dorbalazs/big_muff_pi_2_bass/resources.pdf

Resources
- The Big Muff PI 2 schematic derived from the original paper-drawings (https://www.gigaheartsfx.com/products/gig-buff-pcb-v1_3)
- Electro Smash Big Muff PI analysis (https://www.electrosmash.com/big-muff-pi-analysis)
- Tonestack calculator (https://tonestack.yuriturov.com)
- Op-amp based fuzz (https://docs.pedalpcb.com/project/SourGrape.pdf)
- Why your clean blends suck (https://forum.pedalpcb.com/threads/why-your-clean-blends-suck-or-how-to-clean-blend.20986/)
- PedalPCB Red Muffin Fuzz (https://docs.pedalpcb.com/project/RedMuffin-PedalPCB.pdf)
- Obsidius Preamp - Darkglass B3K clone (https://docs.pedalpcb.com/project/Obsidius.pdf)
- Panner blend (http://www.geofex.com/Article_Folders/panner.pdf)
- Bass big muff trace (https://www.freestompboxes.org/viewtopic.php?f=1&p=285716&t=31296&sid=4f5c3a3a720bbd048505c8e43db66121)
- Changing the mid scoop frequency spectrum (https://www.coda-effects.com/2015/09/black-keyss-big-muff-dealing-with-mids.html)
- Way Huge Pickle clone (https://docs.pedalpcb.com/project/Gerkin.pdf)

v1
- use EQD Hoof tonestack
- omit “bass boost” from bass big muff - or rather not because it would be wasteful for a tl074
- gain of final makeup stage shall be ~2 (6dB)
- make the 68k series resistor in the bass blend path a 100k trimmer
- add passive master volume control
- make most blends trimmable/socketable

technical notes
- POM1615 pot datasheet (https://www.hestore.hu/prod_getfile.php?id=3109)
- Hestore 3PDT stompswitch (https://www.hestore.hu/prod_10038654.html)
- DPDT Switch (https://www.hestore.hu/prod_getfile.php?id=15750)
- 1590BB on Hammond’s site. (https://www.hammfg.com/part/1590BB)
- Audio Jack (https://www.hestore.hu/prod_getfile.php?id=19268)
- DC Jack (https://www.hestore.hu/prod_10038660.html)

TODO:
- create 3PDT footswitch daughter board. put the LED on there
- create 3d model for 3PDT footswitch using FreeCAD
- rethink the thing for a 1590BB
