dorbalazs/big_muff_pi_2_bass/bassmuff.png

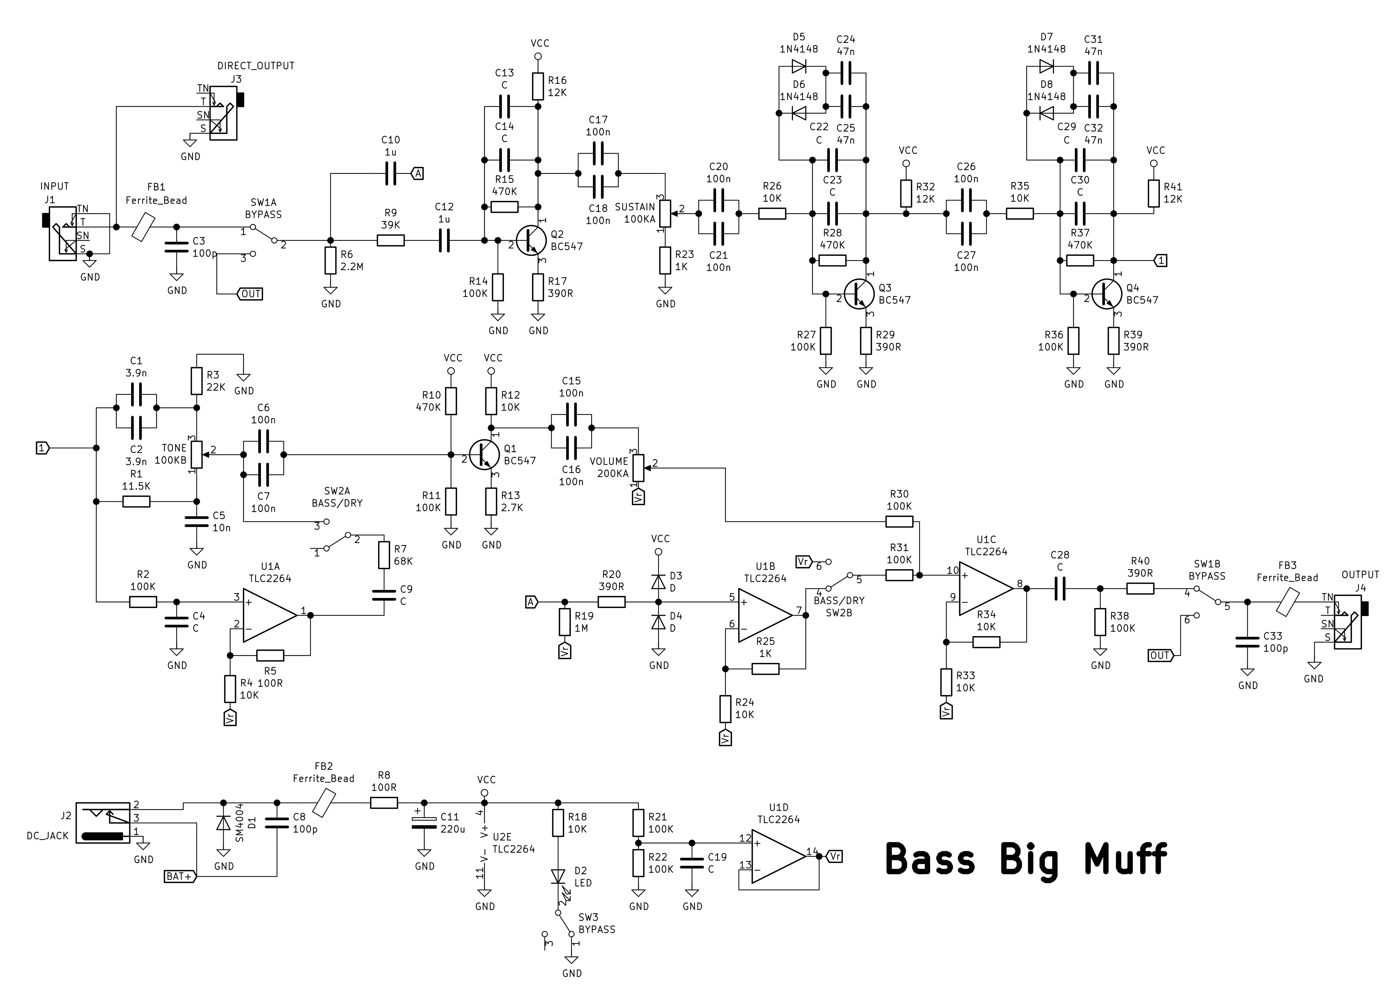
bassmuff.png
