dorbalazs/big_muff_pi_2_bass/exports/bass_big_muff2.pdf

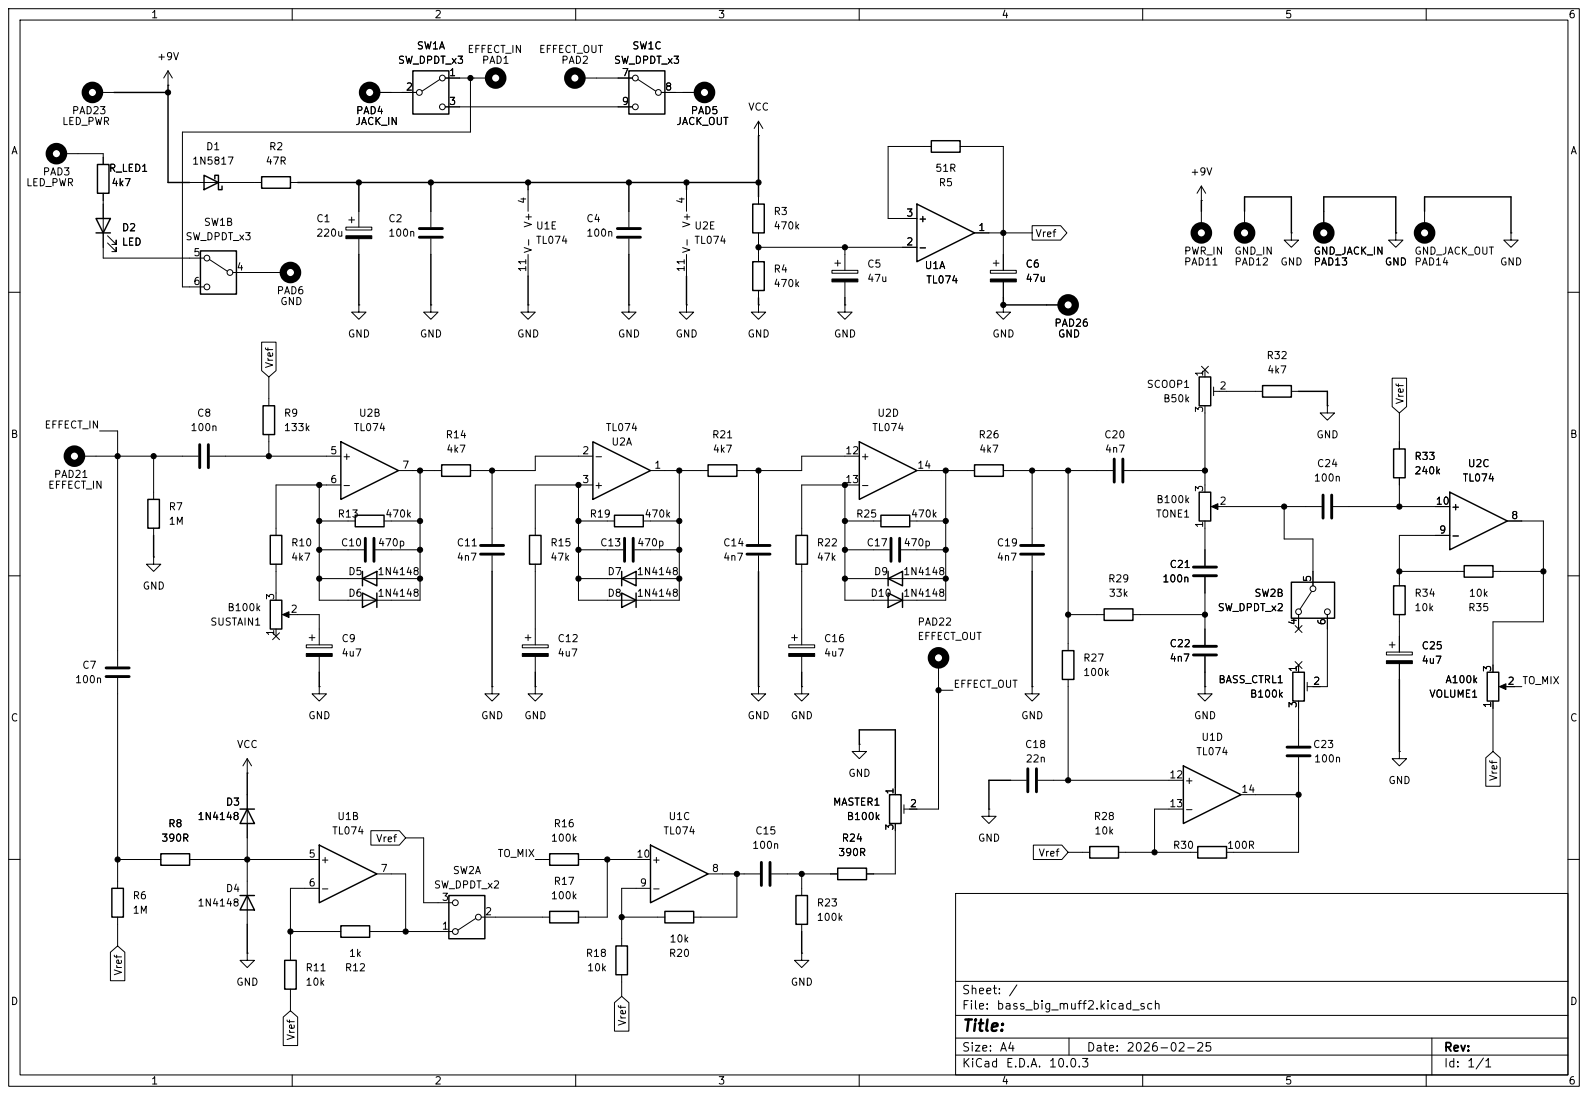
[picture p2: page 1]

Size: A4 | Rev:
KiCad E.D.A. 10.0.3 | Id: 1/1
