dorbalazs/big_muff_pi_2_bass/bass_big_muff2.kicad_pcb

## KiCad design bass_big_muff2.kicad_pcb (2026-07-04)

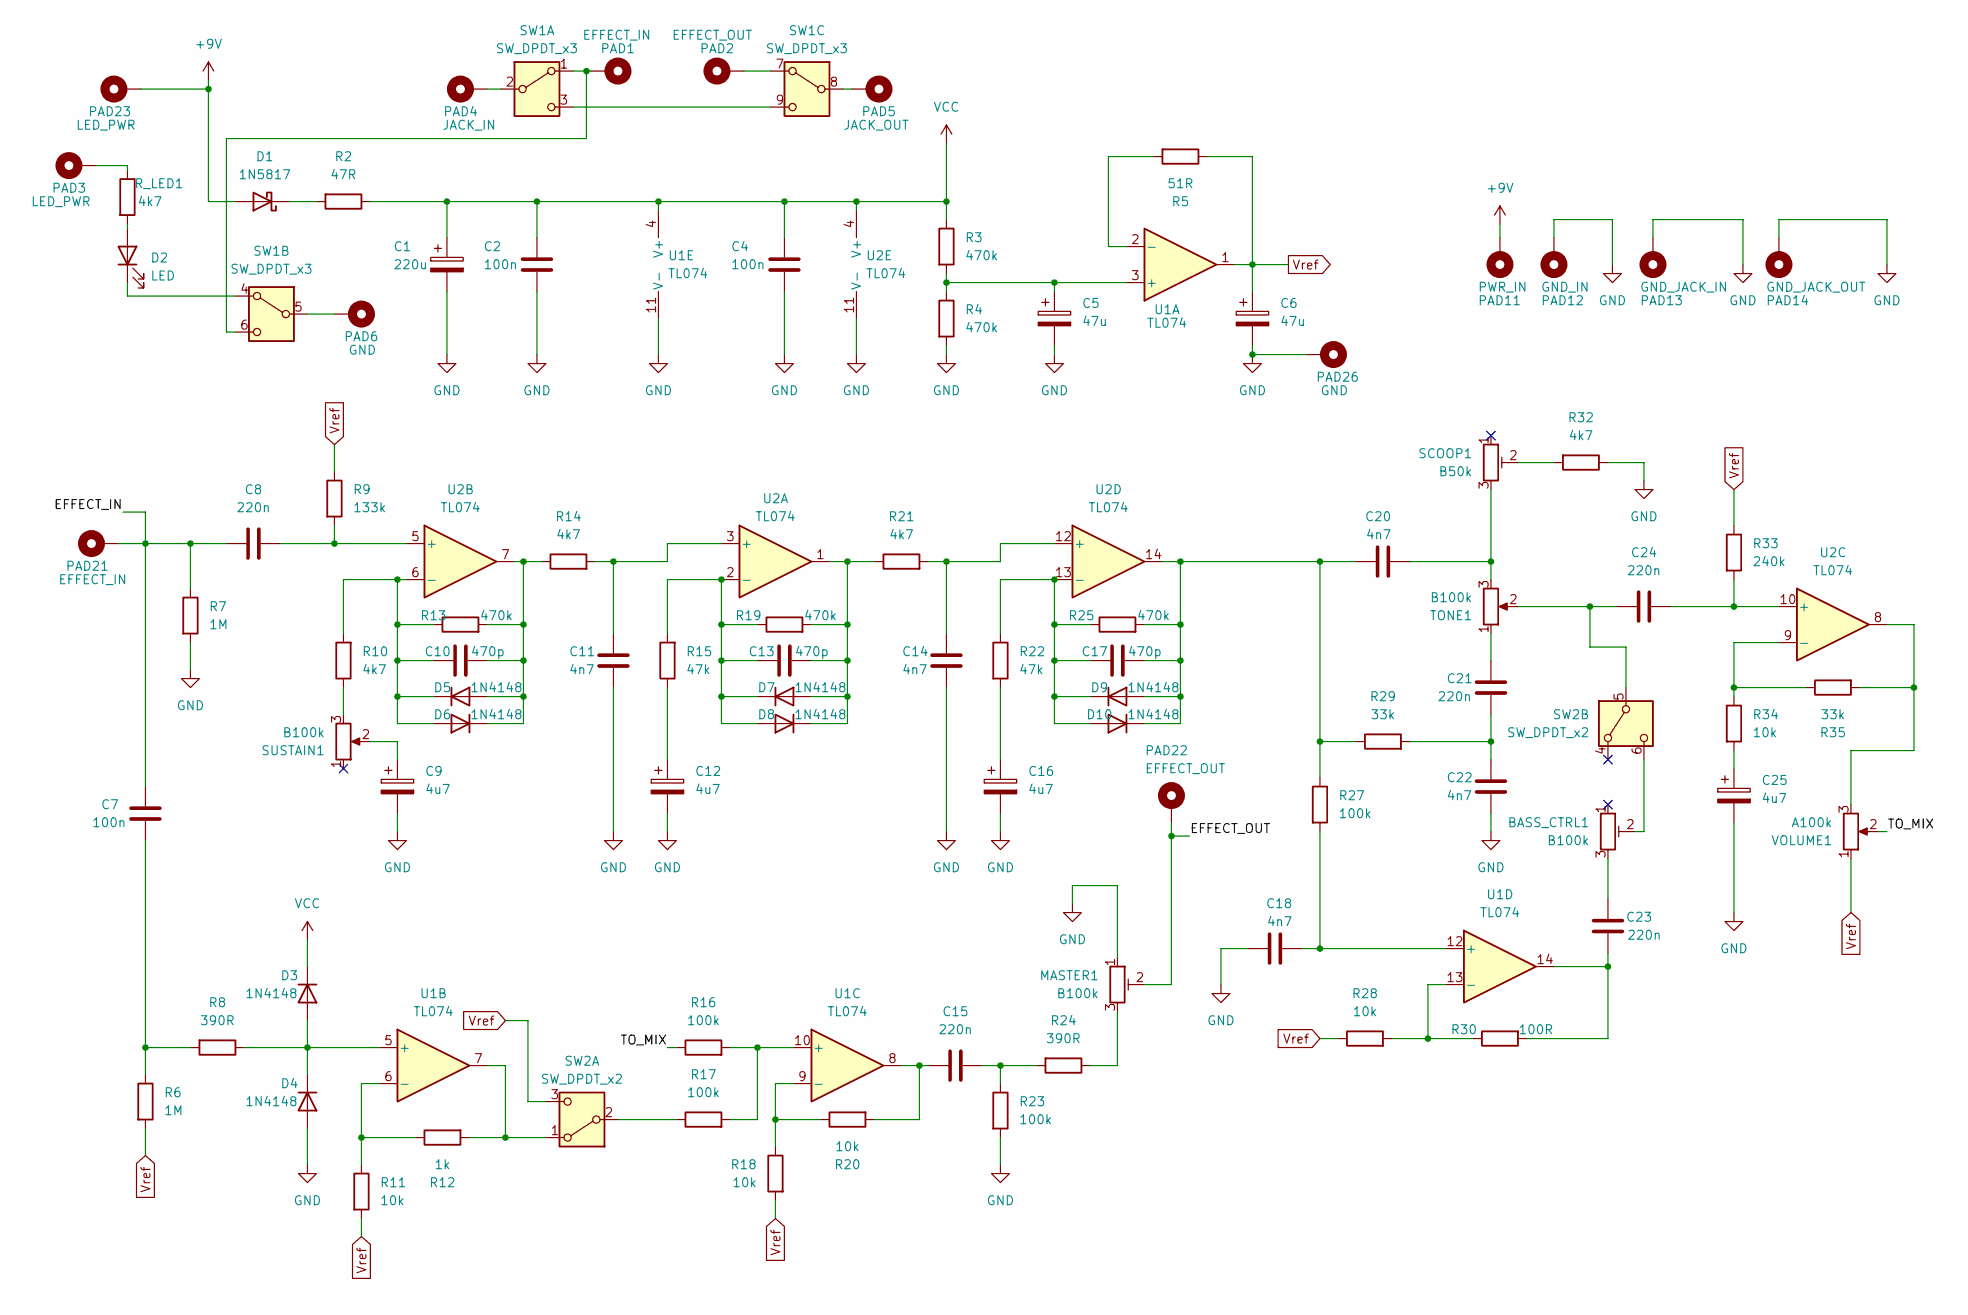
[picture p3: schematic bass_big_muff2.kicad_sch]

Parts:
BASS_CTRL1: B100k; Potentiometer_Runtron_RM-065_Vertical
C1: 220u; CP_Radial_D6.3mm_P2.50mm
C2, C4: 100n; C_Disc_D5.0mm_W2.5mm_P2.50mm
C5, C6: 47u; CP_Radial_D5.0mm_P2.50mm
C7: 100n; C_Rect_L7.2mm_W3.5mm_P5.00mm
C8, C15, C21, C23, C24: 220n; C_Rect_L7.2mm_W3.5mm_P5.00mm
C9, C12, C16, C25: 4u7; CP_Radial_D4.0mm_P1.50mm
C10, C13, C17: 470p; C_Disc_D3.4mm_W2.1mm_P2.50mm
C11, C14, C18, C20, C22: 4n7; C_Rect_L7.2mm_W2.5mm_P5.00mm
D1: 1N5817; D_DO-41_SOD81_P10.16mm_Horizontal
D2: LED; LED_D5.0mm
D3, D4, D5, D6, D7, D8, D9, D10: 1N4148; D_DO-35_SOD27_P7.62mm_Horizontal
MASTER1: B100k; Potentiometer_Runtron_RM-065_Vertical
PAD1, PAD21: EFFECT_IN; SolderWire-0.5sqmm_1x01_D0.9mm_OD2.1mm
PAD2, PAD22: EFFECT_OUT; SolderWire-0.5sqmm_1x01_D0.9mm_OD2.1mm
PAD3, PAD23: LED_PWR; SolderWire-0.5sqmm_1x01_D0.9mm_OD2.1mm
PAD4: JACK_IN; SolderWire-0.5sqmm_1x01_D0.9mm_OD2.1mm
PAD5: JACK_OUT; SolderWire-0.5sqmm_1x01_D0.9mm_OD2.1mm
PAD6, PAD26: GND; SolderWire-0.5sqmm_1x01_D0.9mm_OD2.1mm
PAD11: PWR_IN; SolderWire-0.5sqmm_1x01_D0.9mm_OD2.1mm
PAD12: GND_IN; SolderWire-0.5sqmm_1x01_D0.9mm_OD2.1mm
PAD13: GND_JACK_IN; SolderWire-0.5sqmm_1x01_D0.9mm_OD2.1mm
PAD14: GND_JACK_OUT; SolderWire-0.5sqmm_1x01_D0.9mm_OD2.1mm
R2: 47R; R_Axial_DIN0207_L6.3mm_D2.5mm_P7.62mm_Horizontal
R3, R4, R25: 470k; R_Axial_DIN0207_L6.3mm_D2.5mm_P7.62mm_Horizontal
R5: 51R; R_Axial_DIN0207_L6.3mm_D2.5mm_P7.62mm_Horizontal
R6, R7: 1M; R_Axial_DIN0207_L6.3mm_D2.5mm_P7.62mm_Horizontal
R8, R24: 390R; R_Axial_DIN0207_L6.3mm_D2.5mm_P7.62mm_Horizontal
R9: 133k; R_Axial_DIN0207_L6.3mm_D2.5mm_P2.54mm_Vertical
R10, R14, R32: 4k7; R_Axial_DIN0207_L6.3mm_D2.5mm_P2.54mm_Vertical
R11, R34: 10k; R_Axial_DIN0207_L6.3mm_D2.5mm_P7.62mm_Horizontal
R12: 1k; R_Axial_DIN0207_L6.3mm_D2.5mm_P7.62mm_Horizontal
R13, R19: 470k; R_Axial_DIN0207_L6.3mm_D2.5mm_P2.54mm_Vertical
R15: 47k; R_Axial_DIN0207_L6.3mm_D2.5mm_P2.54mm_Vertical
R16, R17: 100k; R_Axial_DIN0207_L6.3mm_D2.5mm_P2.54mm_Vertical
R18, R20, R28: 10k; R_Axial_DIN0207_L6.3mm_D2.5mm_P2.54mm_Vertical
R21: 4k7; R_Axial_DIN0207_L6.3mm_D2.5mm_P7.62mm_Horizontal
R22: 47k; R_Axial_DIN0207_L6.3mm_D2.5mm_P7.62mm_Horizontal
R23, R27: 100k; R_Axial_DIN0207_L6.3mm_D2.5mm_P7.62mm_Horizontal
R29, R35: 33k; R_Axial_DIN0207_L6.3mm_D2.5mm_P7.62mm_Horizontal
R30: 100R; R_Axial_DIN0207_L6.3mm_D2.5mm_P2.54mm_Vertical
R33: 240k; R_Axial_DIN0207_L6.3mm_D2.5mm_P7.62mm_Horizontal
R_LED1: 4k7; R_Axial_DIN0207_L6.3mm_D2.5mm_P7.62mm_Horizontal
SCOOP1: B50k; Potentiometer_Runtron_RM-065_Vertical
SUSTAIN1: B100k; POM1615
SW1: SW_DPDT_x3; 3PDT-M12
SW2: SW_DPDT_x2; TSM202
TONE1: B100k; POM1615
U1, U2: TL074; DIP-14_W7.62mm_Socket
VOLUME1: A100k; POM1615

Connections:
+9V: D1.2 (A), PAD11.1 (1_1), PAD23.1 (1_1)
/EFFECT_IN: C7.1, C8.2, PAD21.1 (1_1), R7.1
/EFFECT_OUT: MASTER1.2, PAD22.1 (1_1)
/TO_MIX: R16.1, VOLUME1.2
GND: C1.2, C2.2, C4.2, C5.2, C6.2, C9.2, C11.2, C12.2, C14.2, C16.2, C18.1, C22.2, C25.2, D4.2 (A), MASTER1.1, PAD12.1 (1_1), PAD13.1 (1_1), PAD14.1 (1_1), PAD26.1 (1_1), R4.2, R7.2, R23.2, R32.1, U1.11 (V-), U2.11 (V-)
unnamed: BASS_CTRL1.3, C23.1
unnamed: C7.2, R6.1, R8.2
unnamed: C9.1, SUSTAIN1.2
unnamed: C12.1, R15.1
unnamed: C15.1, R23.1, R24.2
unnamed: C15.2, R20.2, U1.8
unnamed: C16.1, R22.2
unnamed: C20.2, SCOOP1.3, TONE1.3
unnamed: C21.1, TONE1.1
unnamed: C21.2, C22.1, R29.2
unnamed: C23.2, R30.2, U1.14
unnamed: C25.1, R34.2
unnamed: D1.1 (K), R2.2
unnamed: D2.2 (A), R_LED1.2
unnamed: D2.1 (K), SW1.4 (A)
unnamed: D3.2 (A), D4.1 (K), R8.1, U1.5 (+)
unnamed: C10.2, D5.2 (A), D6.1 (K), R13.2, R14.1, U2.7
unnamed: C10.1, D5.1 (K), D6.2 (A), R10.2, R13.1, U2.6 (-)
unnamed: C13.2, D7.2 (A), D8.1 (K), R19.2, R21.1, U2.1
unnamed: C13.1, D7.1 (K), D8.2 (A), R15.2, R19.1, U2.2 (-)
unnamed: C17.1, D9.1 (K), D10.2 (A), R22.1, R25.1, U2.13 (-)
unnamed: C17.2, C20.1, D9.2 (A), D10.1 (K), R25.2, R27.1, R29.1, U2.14
unnamed: MASTER1.3, R24.1
unnamed: PAD3.1 (1_1), R_LED1.1
unnamed: R10.1, SUSTAIN1.3
unnamed: R32.2, SCOOP1.2
unnamed: R35.2, U2.8, VOLUME1.3
unnamed: PAD1.1 (1_1), SW1.1 (A), SW1.6 (C)
unnamed: PAD4.1 (1_1), SW1.2 (B)
unnamed: SW1.3 (C), SW1.9 (C)
unnamed: PAD6.1 (1_1), SW1.5 (B)
unnamed: PAD2.1 (1_1), SW1.7 (A)
unnamed: PAD5.1 (1_1), SW1.8 (B)
unnamed: R12.2, SW2.1 (A), U1.7
unnamed: R17.1, SW2.2 (B)
unnamed: C24.2, SW2.5 (B), TONE1.2
unnamed: BASS_CTRL1.2, SW2.6 (C)
unnamed: C5.1, R3.2, R4.1, U1.3 (+)
unnamed: R5.2, U1.2 (-)
unnamed: R11.1, R12.1, U1.6 (-)
unnamed: R16.2, R17.2, U1.10 (+)
unnamed: R18.1, R20.1, U1.9 (-)
unnamed: C18.2, R27.2, U1.12 (+)
unnamed: R28.2, R30.1, U1.13 (-)
unnamed: C11.1, R14.2, U2.3 (+)
unnamed: C8.1, R9.2, U2.5 (+)
unnamed: C24.1, R33.2, U2.10 (+)
unnamed: R34.1, R35.1, U2.9 (-)
unnamed: C14.1, R21.2, U2.12 (+)
VCC: C1.1, C2.1, C4.1, D3.1 (K), R2.1, R3.1, U1.4 (V+), U2.4 (V+)
Vref: C6.1, R5.1, R6.2, R9.1, R11.2, R18.2, R28.1, R33.1, SW2.3 (C), U1.1, VOLUME1.1

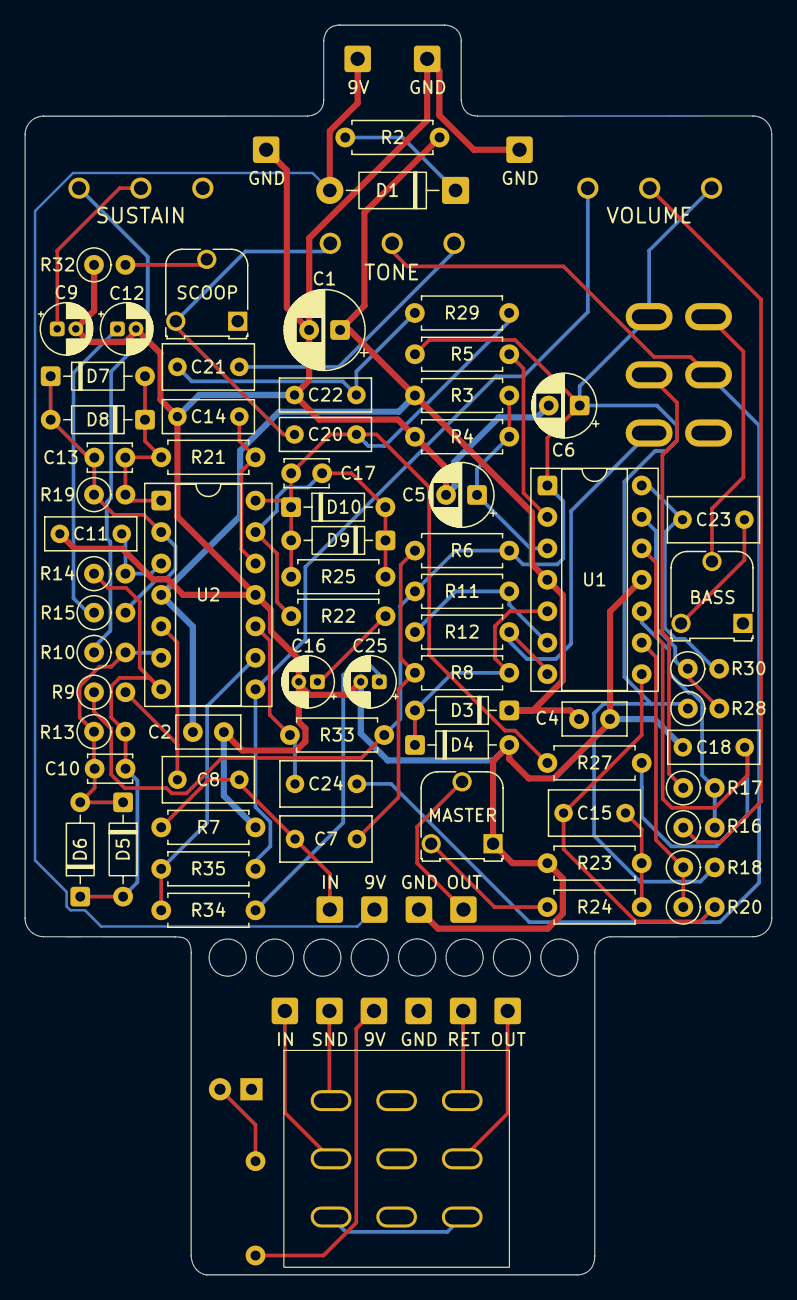
[picture p4: board bass_big_muff2.kicad_pcb from above]

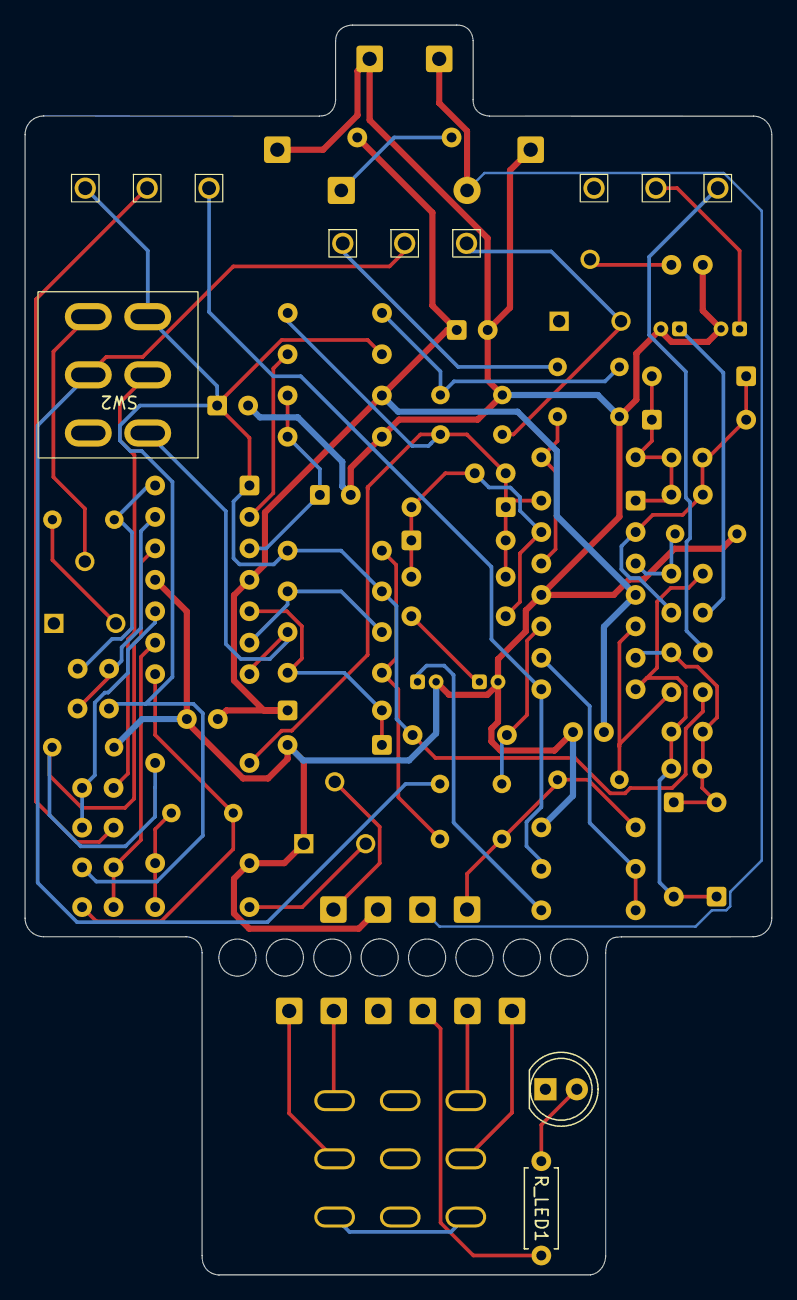
[picture p5: board bass_big_muff2.kicad_pcb from below]

Board: 2 copper layers, 60.3 x 101.0 mm, 90 parts (6 on the bottom side), 56 nets.
