dorbalazs/big_muff_pi_2_bass/(commit log)

2026-07-03 initial - not fully functioning
    [bass_big_muff2-B_Cu.gbl, bass_big_muff2-B_Mask.gbs, bass_big_muff2-B_Paste.gbp, bass_big_muff2-B_Silkscreen.gbo, bass_big_muff2-Edge_Cuts.gm1, bass_big_muff2-F_Cu.gtl, bass_big_muff2-F_Mask.gts, bass_big_muff2-F_Paste.gtp]
2026-07-03 debugging - added todo items
    [bass_big_muff2.kicad_sch]
